DominicTYLau/Self-Centring-RC-Car/README.md

# Self-Centring-RC-Car

The Lane Detection RC Car is a project featuring a 3D printed remote-controlled car with a camera for autonomous lane detection. Users can switch between autonomous and manual modes using the joystick.

Self Centring RC Car Demo (https://youtu.be/osQpQSczceI)
